ideapad2009/STM32-graphical-Equalizer/Images/STM32F413CG_WM8731.png

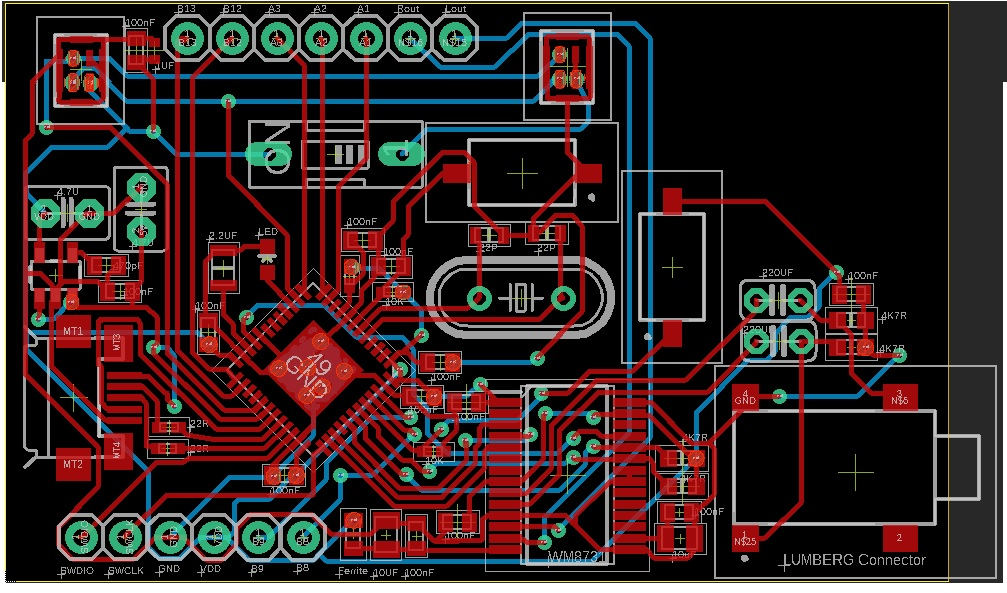
Images/STM32F413CG_WM8731.png
