ideapad2009/STM32-graphical-Equalizer/Images/Phase Response Matlab_2.png

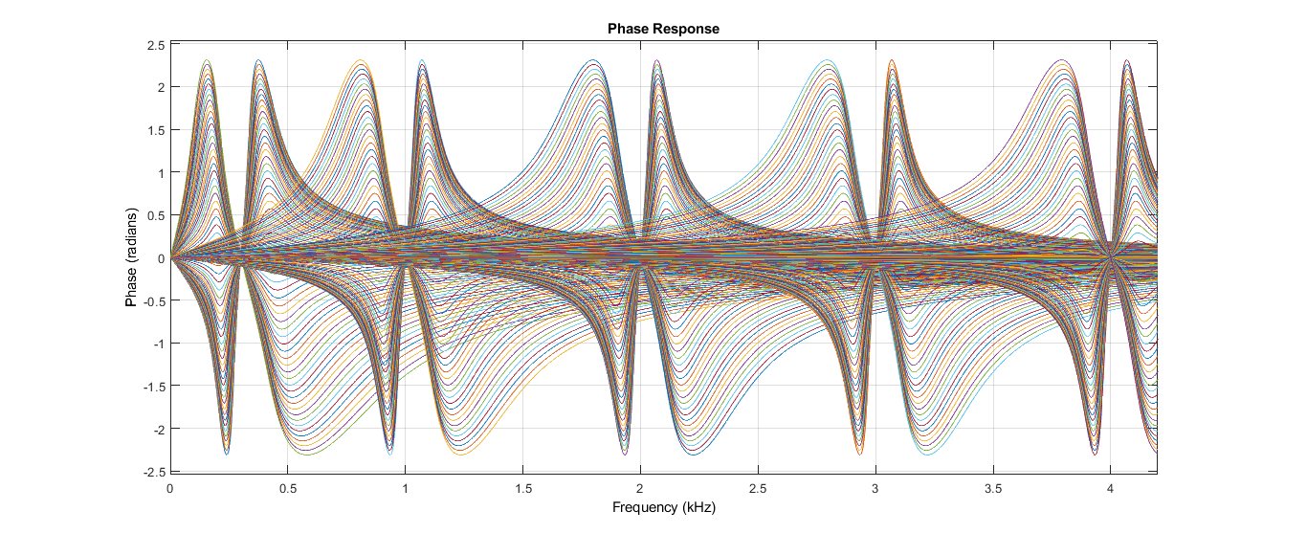
Images/Phase Response Matlab_2.png
