ideapad2009/STM32-graphical-Equalizer/README.md

# STM32-graphical-Equalizer
## STM32F413CG real-time graphical Equalizer using Mems Microphone & DFSDM for Audio Acquisition, I2S & WM8731 codec
