ideapad2009/STM32-graphical-Equalizer/Images/FFT Analyzer.PNG

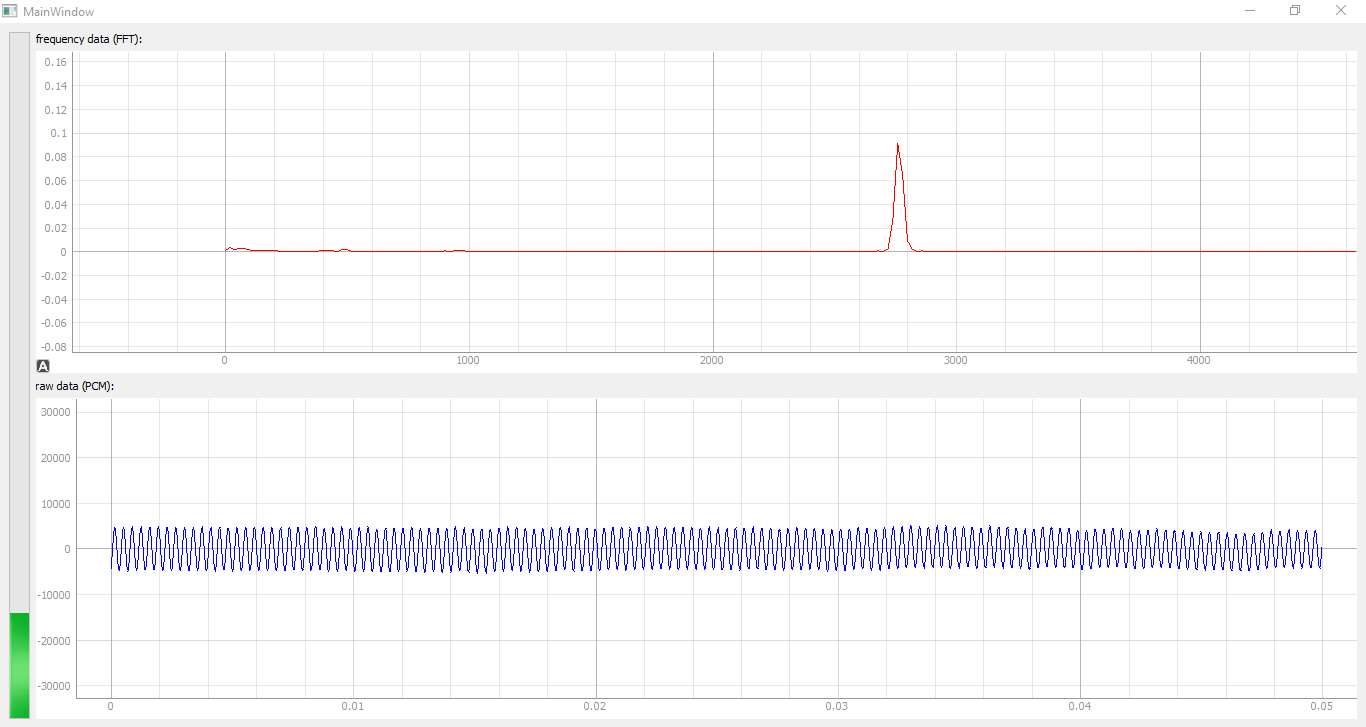
Images/FFT Analyzer.PNG
