ideapad2009/STM32-graphical-Equalizer/Images/Frequency Response Matlab.png

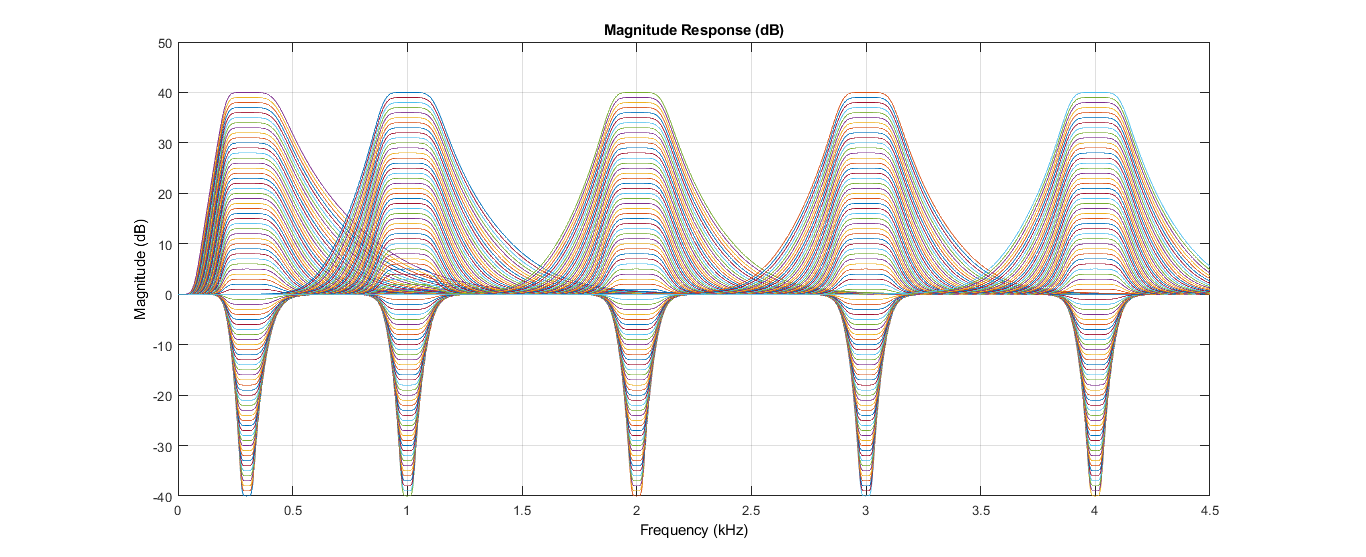
Images/Frequency Response Matlab.png
