ideapad2009/STM32-graphical-Equalizer/Images/Frequency Response Matlab_3.png

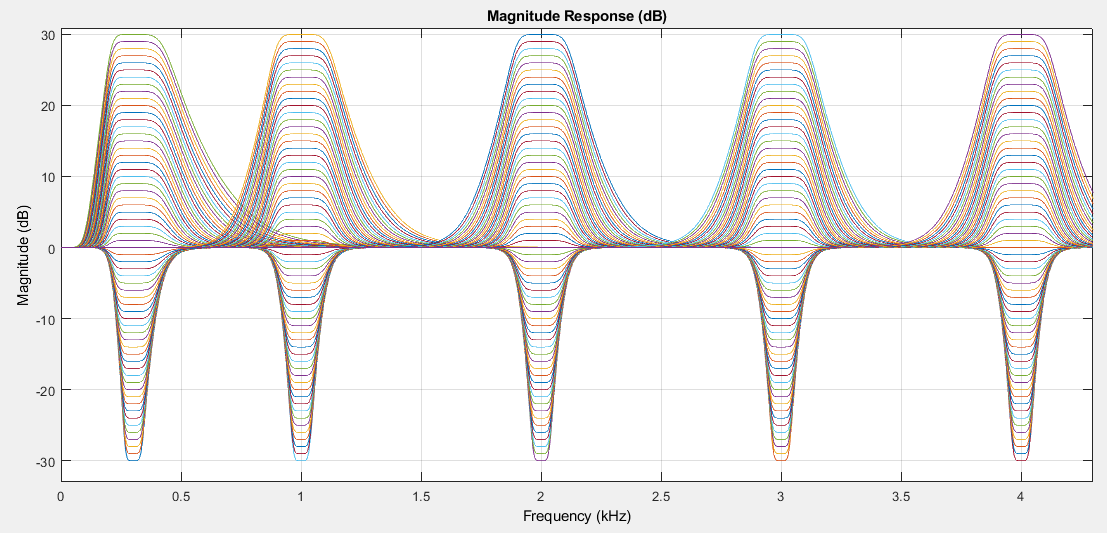
Images/Frequency Response Matlab_3.png
