ideapad2009/STM32-graphical-Equalizer/Images/HSI setting.PNG

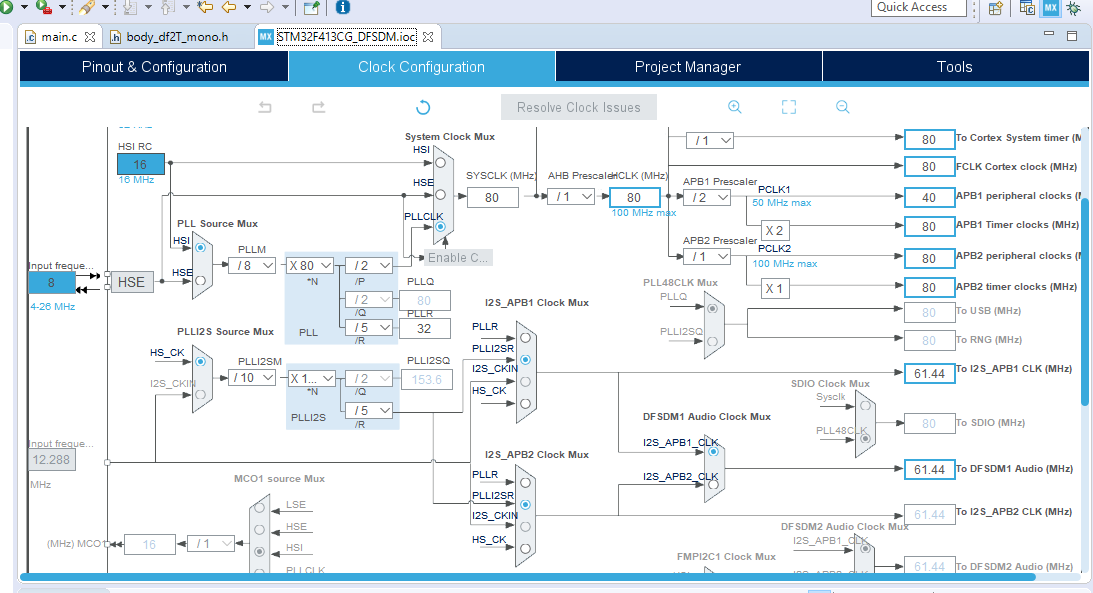
Images/HSI setting.PNG
