ideapad2009/STM32-graphical-Equalizer/Images/Mobile app.jpg

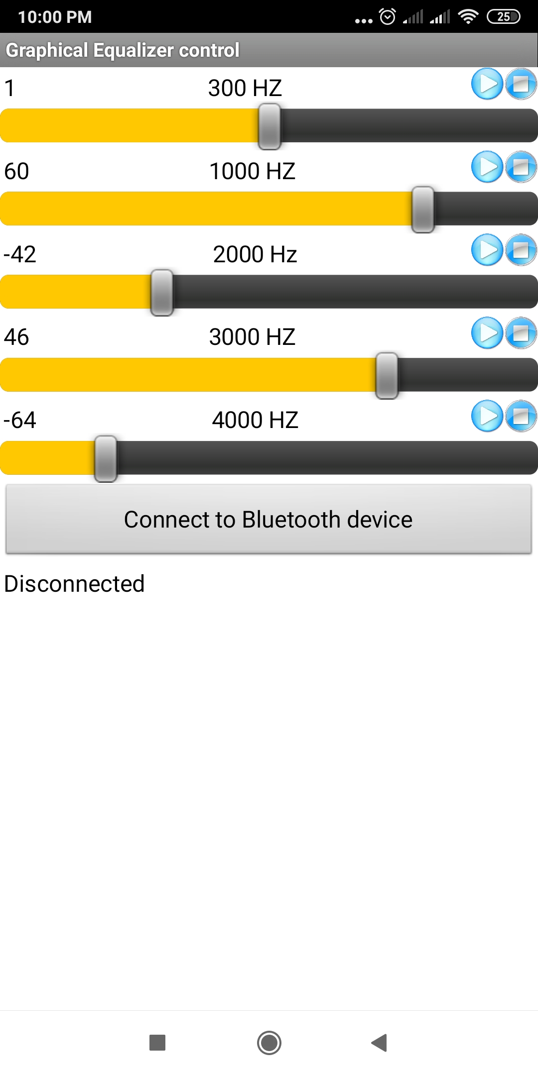
Images/Mobile app.jpg
