ideapad2009/STM32-graphical-Equalizer/Images/optimum CubeMX design printed PCB.PNG

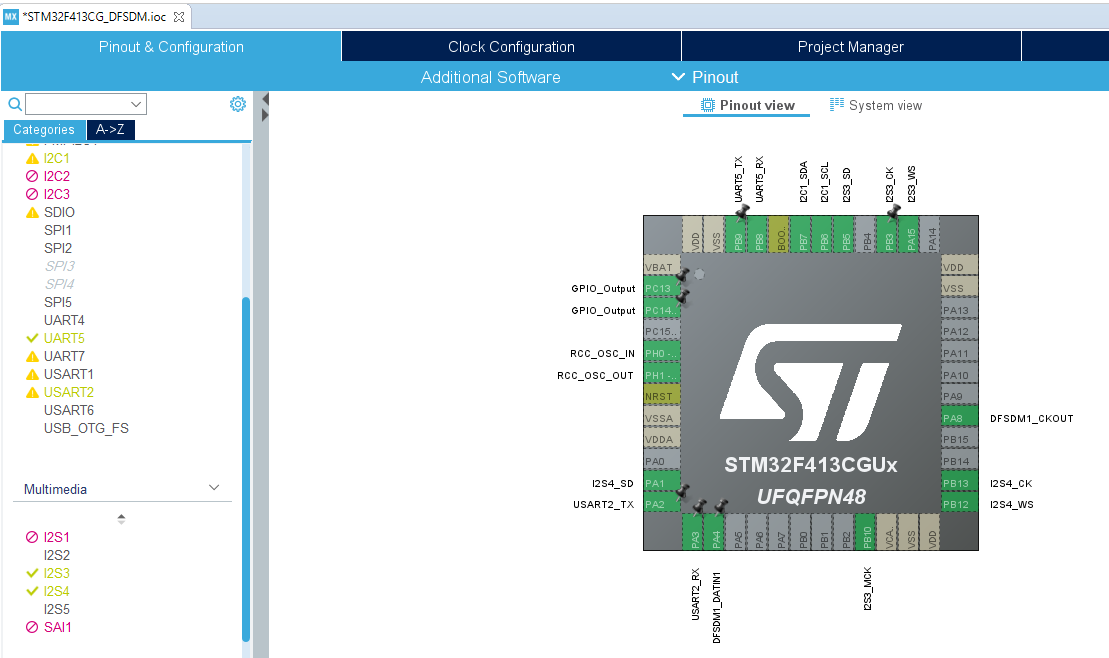
Images/optimum CubeMX design printed PCB.PNG
