ideapad2009/STM32-graphical-Equalizer/STM32F413CG_PCB/STM32F413CG_WM8731.brd

## EAGLE design STM32F413CG_PCB/STM32F413CG_WM8731.brd (2020-08-03)

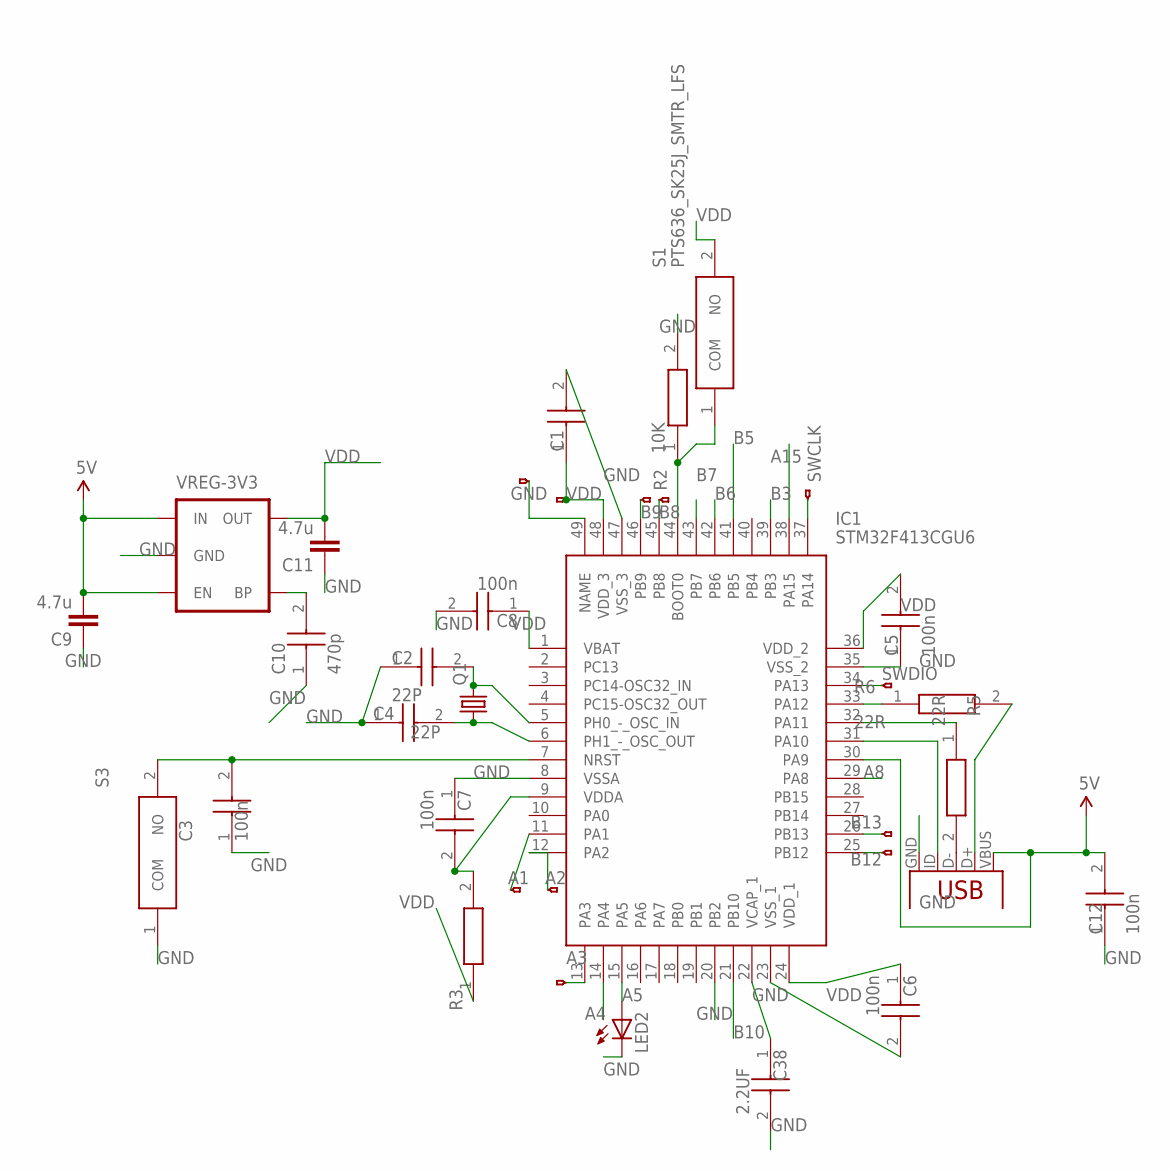
[picture p9: schematic STM32F413CG_WM8731.sch, sheet 1]

Parts:
C1: C0603C104M4RAC7411; CAPC1608X95N
C2, C4: 22P; CAPC1608X80N
C3, C5, C6, C7, C8, C12: 100n; CAPC1608X95N
C9, C11: 4.7u; C2.5-3
C10: 470p; CAPC1608X87N
C38: 2.2UF; CAPC2012X145N
IC1: STM32F413CGU6; QFN50P700X700X60-49N
JP1, JP2, JP3, JP4, JP5, JP6, JP7, JP8, JP9, JP10, JP11: HEADERHOLE-HEADERHOLE; 1X1-HEADER-HOLE
LED2: LED0603; LED-0603
Q1: CRYSTALHC49S; HC49/S
R2: 10K; RESC1005X40N
R3: CRCW040222R0FKED; RESC1005X40N
R5, R6: 22R; RESC1005X40N
S1, S3: PTS636_SK25J_SMTR_LFS; PTS636SK25JSMTRLFS
VREG-3V3: V_REG_LDOSMD; SOT23-5
X1: USB-MICROB-SMD

Connections:
5V: C9.2, C12.2, IC1.30 (PA9), VREG-3V3.1 (IN), VREG-3V3.3 (EN), X1.VBUS
A1: IC1.11 (PA1), JP8.1
A2: IC1.12 (PA2), JP9.1
A3: IC1.13 (PA3), JP10.1
A4: IC1.14 (PA4); also elsewhere on the board
A5: IC1.15 (PA5), LED2.A
A8: IC1.29 (PA8); also elsewhere on the board
A15: IC1.38 (PA15); also elsewhere on the board
B3: IC1.39 (PB3); also elsewhere on the board
B5: IC1.41 (PB5); also elsewhere on the board
B6: IC1.42 (PB6); also elsewhere on the board
B7: IC1.43 (PB7); also elsewhere on the board
B8: IC1.45 (PB8), JP5.1
B9: IC1.46 (PB9), JP11.1
B10: IC1.21 (PB10); also elsewhere on the board
B12: IC1.25 (PB12), JP7.1
B13: IC1.26 (PB13), JP6.1
GND: C1.2, C2.1, C3.1, C4.1, C5.1, C6.2, C7.1, C8.2, C9.1, C10.1, C11.1, C12.1, C38.2, IC1.8 (VSSA), IC1.20 (PB2), IC1.23 (VSS_1), IC1.35 (VSS_2), IC1.47 (VSS_3), IC1.49 (NAME), JP1.1, LED2.C, R2.2, S3.1 (COM), VREG-3V3.2 (GND), X1.GND; also elsewhere on the board
unnamed: C2.2, IC1.5 (PH0_-_OSC_IN), Q1.2
unnamed: C3.2, IC1.7 (NRST), S3.2 (NO)
unnamed: C10.2, VREG-3V3.4 (BP)
unnamed: C7.2, IC1.9 (VDDA), R3.2
unnamed: R5.2, X1.D-
unnamed: IC1.31 (PA10), X1.ID
unnamed: IC1.32 (PA11), R5.1
unnamed: R6.2, X1.D+
unnamed: IC1.33 (PA12), R6.1
unnamed: IC1.44 (BOOT0), R2.1, S1.1 (COM)
unnamed: C4.2, IC1.6 (PH1_-_OSC_OUT), Q1.1
unnamed: C38.1, IC1.22 (VCAP_1)
SWCLK: IC1.37 (PA14), JP2.1
SWDIO: IC1.34 (PA13), JP3.1
VDD: C1.1, C5.2, C6.1, C8.1, C11.2, IC1.1 (VBAT), IC1.24 (VDD_1), IC1.36 (VDD_2), IC1.48 (VDD_3), JP4.1, R3.1, S1.2 (NO), VREG-3V3.5 (OUT); also elsewhere on the board

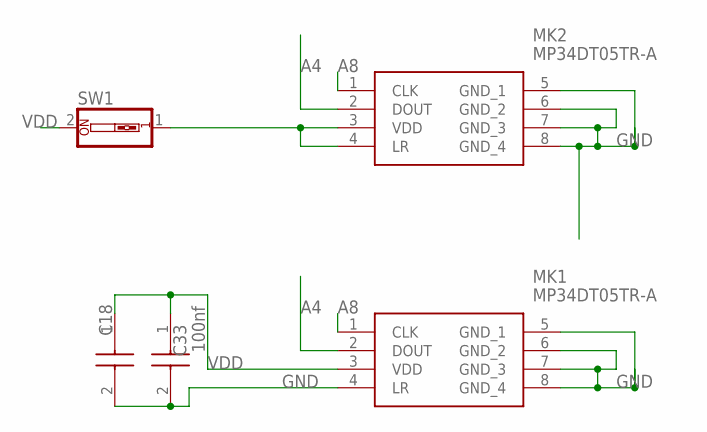
[picture p10: schematic STM32F413CG_WM8731.sch, sheet 2]

Parts:
C18: 1UF; CAPC1005X55N
C33: 100nf; CAPC1608X95N
MK1, MK2: MP34DT05TR-A; MP34DT05TRA
SW1: SW_DIP-1; EDG-01

Connections:
A4: MK1.2 (DOUT), MK2.2 (DOUT); also elsewhere on the board
A8: MK1.1 (CLK), MK2.1 (CLK); also elsewhere on the board
GND: C18.2 (C2), C33.2, MK1.4 (LR), MK1.5 (GND_1), MK1.6 (GND_2), MK1.7 (GND_3), MK1.8 (GND_4), MK2.5 (GND_1), MK2.6 (GND_2), MK2.7 (GND_3), MK2.8 (GND_4); also elsewhere on the board
unnamed: MK2.3 (VDD), MK2.4 (LR), SW1.1
VDD: C18.1 (C1), C33.1, MK1.3 (VDD), SW1.2; also elsewhere on the board

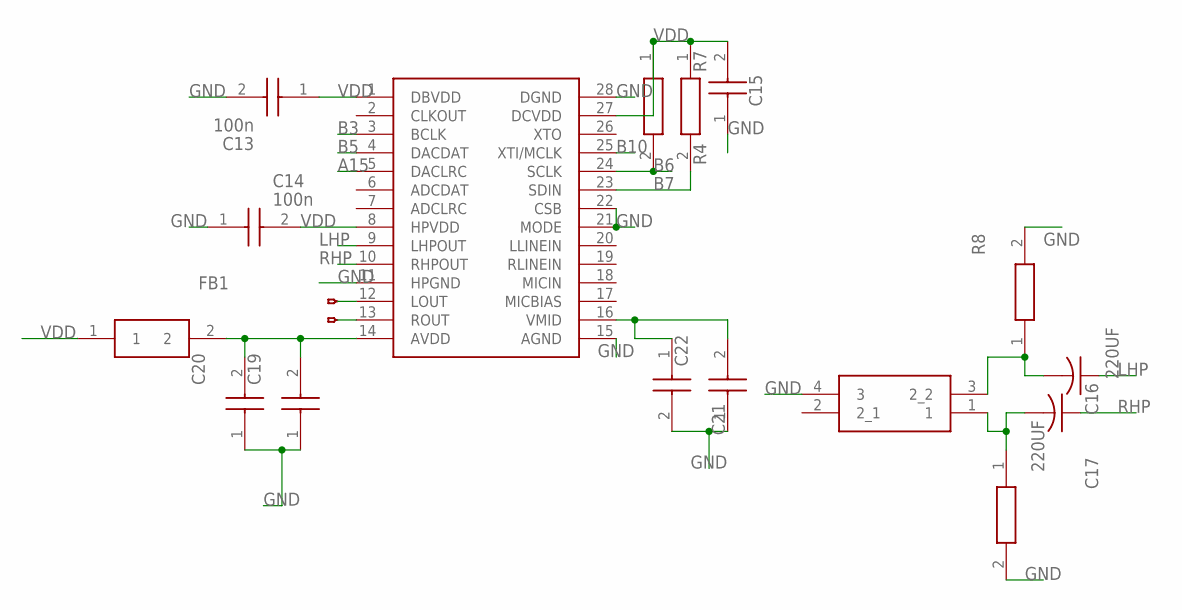
[picture p11: schematic STM32F413CG_WM8731.sch, sheet 3]

Parts:
C13, C14: 100n; CAPC1608X95N
C15, C19, C22: C0603C104M4RAC7411; CAPC1608X95N
C16, C17: 220UF; C025-024X044
C20: CL21A106KAYNNNE_10UF; CAPC2012X145N
C21: CL21A106KAYNNNE; CAPC2012X145N
FB1: BLM18BD252SN1D; BEADC1608X95N
IC2: WM8731SEDS_RV; SOP65P780X200-28N
J2: 1503_02; 150302
JP12, JP13: HEADERHOLE-HEADERHOLE; 1X1-HEADER-HOLE
R4, R7, R8, R9: CR0603-JW-472ELF; RESC1608X55N

Connections:
A15: IC2.5 (DACLRC); also elsewhere on the board
B3: IC2.3 (BCLK); also elsewhere on the board
B5: IC2.4 (DACDAT); also elsewhere on the board
B6: IC2.24 (SCLK), R4.2; also elsewhere on the board
B7: IC2.23 (SDIN), R7.2; also elsewhere on the board
B10: IC2.25 (XTI/MCLK); also elsewhere on the board
GND: C13.2, C14.1, C15.1, C19.1, C20.1, C21.2, C22.1, IC2.11 (HPGND), IC2.15 (AGND), IC2.21 (MODE), IC2.22 (CSB), IC2.28 (DGND), J2.4 (3), R8.2, R9.2; also elsewhere on the board
LHP: C16.1, IC2.9 (LHPOUT)
unnamed: C16.2, J2.3 (2_2), R8.1
unnamed: C19.2, C20.2, FB1.2, IC2.14 (AVDD)
unnamed: C21.1, C22.2, IC2.16 (VMID)
unnamed: IC2.12 (LOUT), JP13.1
unnamed: IC2.13 (ROUT), JP12.1
unnamed: C17.2, J2.1, R9.1
RHP: C17.1, IC2.10 (RHPOUT)
VDD: C13.1, C14.2, C15.2, FB1.1, IC2.1 (DBVDD), IC2.8 (HPVDD), IC2.27 (DCVDD), R4.1, R7.1; also elsewhere on the board

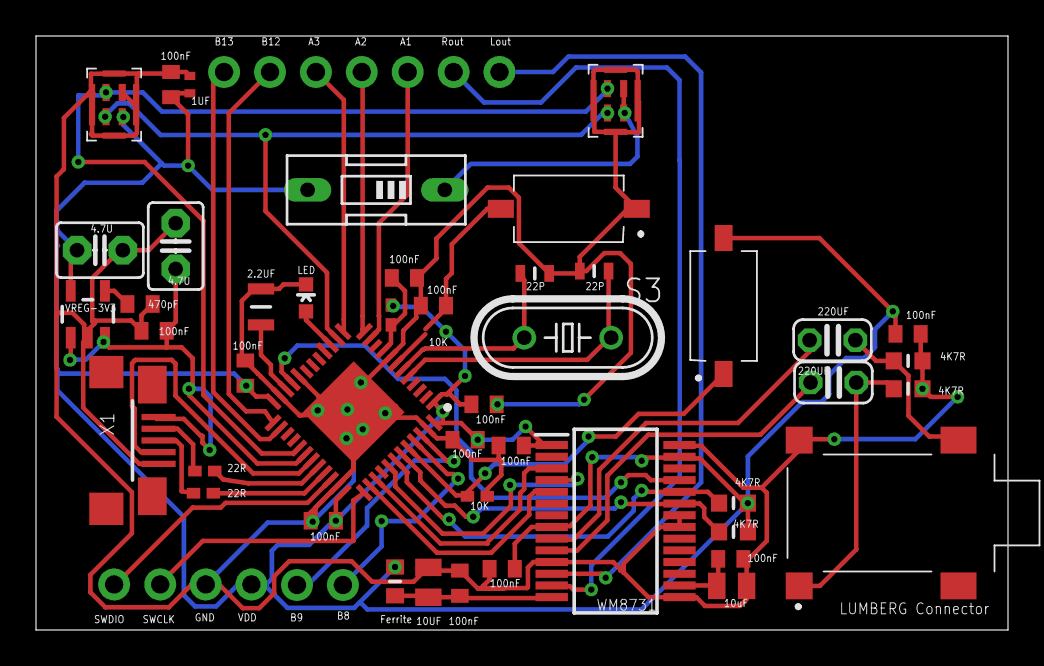
[picture p12: board STM32F413CG_WM8731.brd from above]

Board: 2 copper layers, 54.0 x 33.0 mm, 58 parts (0 on the bottom side), 42 nets.
