ideapad2009/STM32-graphical-Equalizer/STM32L451CE/STM32L451CE.ioc

Mcu.UserName=STM32L451CEUx
PA10.Signal=USART1_RX
PA4.Signal=COMP_DAC11_group
PA5.Signal=S_CKOUTDFSDM1
PA7.Signal=S_DATAIN0DFSDM1
PA8.Signal=GPIO_Output
PA9.Signal=USART1_TX
PB6.Signal=I2C1_SCL
PB7.Signal=I2C1_SDA
PB8.Signal=GPIO_Output
