ideapad2009/STM32-graphical-Equalizer/STM32L451CE/Core/Inc/biquad_band1.h

float band1_coeff[]={
1.000000000000000000f,-1.997781931884465179f,0.999323337720924743f,1.967549337575563495f,-0.969067417193793301f,
1.000000000000000000f,-1.998094240184478121f,0.999659087745291330f,1.976241389706033580f,-0.979288176314729863f,
1.000000000000000000f,-1.998145306585225267f,0.999664135552811417f,1.988802657704017207f,-0.989570745678425179f,
1.000000000000000000f,-1.997755489006195928f,0.999296874440425587f,1.967549337575563495f,-0.969067417193793301f,
1.000000000000000000f,-1.998079899219373345f,0.999645650273652486f,1.976241389706033580f,-0.979288176314729863f,
1.000000000000000000f,-1.998133168177066654f,0.999651100621309574f,1.988802657704017207f,-0.989570745678425179f,
1.000000000000000000f,-1.997728012363215067f,0.999269376597604286f,1.967549337575563495f,-0.969067417193793301f,
1.000000000000000000f,-1.998064988613399873f,0.999631679047974675f,1.976241389706033580f,-0.979288176314729863f,
1.000000000000000000f,-1.998120562734859940f,0.999637564154456260f,1.988802657704017207f,-0.989570745678425179f,
1.000000000000000000f,-1.997699461571394108f,0.999240803777174169f,1.967549337575563495f,-0.969067417193793301f,
1.000000000000000000f,-1.998049485393073255f,0.999617152587052638f,1.976241389706033580f,-0.979288176314729863f,
1.000000000000000000f,-1.998107472615963554f,0.999623507160251501f,1.988802657704017207f,-0.989570745678425179f,
1.000000000000000000f,-1.997669794671397048f,0.999211113987425237f,1.967549337575563495f,-0.969067417193793301f,
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
1.000000000000000000f,-1.997964600860201667f,0.999470082048267483f,1.988802657704017207f,-0.989570745678425179f,
1.000000000000000000f,-1.997344781636683164f,0.998885850186108315f,1.967549337575563495f,-0.969067417193793301f,
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
};
