ideapad2009/STM32-graphical-Equalizer/STM32L451CE/Core/Inc/biquad_band2.h

float band2_coeff[]={
1.000000000000000000f,-1.982218849408146299f,0.999323337720924743f,1.952221772475387196f,-0.969067417193793301f,
1.000000000000000000f,-1.982476809842899312f,0.999660858419490483f,1.961950954032809058f,-0.982825252057011434f,
1.000000000000000000f,-1.982631308281418425f,0.999662364872808573f,1.972204683312451579f,-0.986009393675632118f,
1.000000000000000000f,-1.982192612524680042f,0.999296874440425587f,1.952221772475387196f,-0.969067417193793301f,
1.000000000000000000f,-1.982460621285271785f,0.999647562124498568f,1.961950954032809058f,-0.982825252057011434f,
1.000000000000000000f,-1.982621223744882144f,0.999649188763692798f,1.972204683312451579f,-0.986009393675632118f,
1.000000000000000000f,-1.982165349929716047f,0.999269376597604286f,1.952221772475387196f,-0.969067417193793301f,
1.000000000000000000f,-1.982443796646624179f,0.999633743400717756f,1.961950954032809058f,-0.982825252057011434f,
1.000000000000000000f,-1.982610746690344428f,0.999635499793817606f,1.972204683312451579f,-0.986009393675632118f,
1.000000000000000000f,-1.982137021553725731f,0.999240803777174169f,1.952221772475387196f,-0.969067417193793301f,
1.000000000000000000f,-1.982426310811993275f,0.999619381629718196f,1.961950954032809058f,-0.982825252057011434f,
1.000000000000000000f,-1.982599861933033836f,0.999621278108382194f,1.972204683312451579f,-0.986009393675632118f,
1.000000000000000000f,-1.982107585764243840f,0.999211113987425237f,1.952221772475387196f,-0.969067417193793301f,
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
1.000000000000000000f,-1.982480738816681853f,0.999465635411969755f,1.972204683312451579f,-0.986009393675632118f,
1.000000000000000000f,-1.981785104639837369f,0.998885850186108315f,1.952221772475387196f,-0.969067417193793301f,
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
};
