ideapad2009/STM32-graphical-Equalizer/STM32L451CE/Core/Inc/biquad_band3.h

float band3_coeff[]={
1.000000000000000000f,-1.931198047007102181f,0.999323337720924743f,1.901973071971796214f,-0.969067417193793301f,
1.000000000000000000f,-1.931372575661876478f,0.999661241555557689f,1.908690275083634980f,-0.983631990003573931f,
1.000000000000000000f,-1.931676681578337718f,0.999661981736307159f,1.924203194641800563f,-0.985200705872032456f,
1.000000000000000000f,-1.931172485441019493f,0.999296874440425587f,1.901973071971796214f,-0.969067417193793301f,
1.000000000000000000f,-1.931353815083105108f,0.999647975826320812f,1.908690275083634980f,-0.983631990003573931f,
1.000000000000000000f,-1.931669845312370848f,0.999648775061373063f,1.924203194641800563f,-0.985200705872032456f,
1.000000000000000000f,-1.931145924564471317f,0.999269376597604286f,1.901973071971796214f,-0.969067417193793301f,
1.000000000000000000f,-1.931334319112118392f,0.999634190113312671f,1.908690275083634980f,-0.983631990003573931f,
1.000000000000000000f,-1.931662742314942616f,0.999635053080640268f,1.924203194641800563f,-0.985200705872032456f,
1.000000000000000000f,-1.931118325339287844f,0.999240803777174169f,1.901973071971796214f,-0.969067417193793301f,
1.000000000000000000f,-1.931314058862607874f,0.999619863967125877f,1.908690275083634980f,-0.983631990003573931f,
1.000000000000000000f,-1.931655362209912408f,0.999620795770289172f,1.924203194641800563f,-0.985200705872032456f,
1.000000000000000000f,-1.931089647204592419f,0.999211113987425237f,1.901973071971796214f,-0.969067417193793301f,
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
1.000000000000000000f,-1.931574547542096898f,0.999464673178202645f,1.924203194641800563f,-0.985200705872032456f,
1.000000000000000000f,-1.930775466498543480f,0.998885850186108315f,1.901973071971796214f,-0.969067417193793301f,
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
};
