ideapad2009/STM32-graphical-Equalizer/STM32L451CE/Core/Inc/biquad_band4.h

float band4_coeff[]={
1.000000000000000000f,-1.847133910592513306f,0.999323337720924743f,1.819181084880208354f,-0.969067417193793301f,
1.000000000000000000f,-1.847221762004602308f,0.999661372240002066f,1.822217622647379187f,-0.983908521949802384f,
1.000000000000000000f,-1.847670790520528517f,0.999661851051785177f,1.843831809512394670f,-0.984923810751662465f,
1.000000000000000000f,-1.847109461709296907f,0.999296874440425587f,1.819181084880208354f,-0.969067417193793301f,
1.000000000000000000f,-1.847200729725531954f,0.999648116943525289f,1.822217622647379187f,-0.983908521949802384f,
1.000000000000000000f,-1.847667340173384964f,0.999648633944072884f,1.843831809512394670f,-0.984923810751662465f,
1.000000000000000000f,-1.847084057015126124f,0.999269376597604286f,1.819181084880208354f,-0.969067417193793301f,
1.000000000000000000f,-1.847178873679625966f,0.999634342475216098f,1.822217622647379187f,-0.983908521949802384f,
1.000000000000000000f,-1.847663755091376814f,0.999634900718624042f,1.843831809512394670f,-0.984923810751662465f,
1.000000000000000000f,-1.847057659171144728f,0.999240803777174169f,1.819181084880208354f,-0.969067417193793301f,
1.000000000000000000f,-1.847156161556028131f,0.999620028484866308f,1.822217622647379187f,-0.983908521949802384f,
1.000000000000000000f,-1.847660030031984313f,0.999620631252425618f,1.843831809512394670f,-0.984923810751662465f,
1.000000000000000000f,-1.847030229382071065f,0.999211113987425237f,1.819181084880208354f,-0.969067417193793301f,
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
1.000000000000000000f,-1.847619231353760494f,0.999464344982851194f,1.843831809512394670f,-0.984923810751662465f,
1.000000000000000000f,-1.846729724813367612f,0.998885850186108315f,1.819181084880208354f,-0.969067417193793301f,
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
};
