ideapad2009/STM32-graphical-Equalizer/STM32L451CE/Core/Inc/biquad_band5.h

float band5_coeff[]={
1.000000000000000000f,-1.731464800845415652f,0.999323337720924743f,1.705262405054036590f,-0.969067417193793301f,
1.000000000000000000f,-1.731464404183024275f,0.999661439886804004f,1.704420959392325408f,-0.984051835416423382f,
1.000000000000000000f,-1.732050807635567846f,0.999661783404954374f,1.732057312996608811f,-0.984780370293960150f,
1.000000000000000000f,-1.731441882972235780f,0.999296874440425587f,1.705262405054036590f,-0.969067417193793301f,
1.000000000000000000f,-1.731441454670316737f,0.999648189985098079f,1.704420959392325408f,-0.984051835416423382f,
1.000000000000000000f,-1.732050807645114876f,0.999648560902466232f,1.732057312996608811f,-0.984780370293960150f,
1.000000000000000000f,-1.731418069141803295f,0.999269376597604286f,1.705262405054036590f,-0.969067417193793301f,
1.000000000000000000f,-1.731417606679332755f,0.999634421345324098f,1.704420959392325408f,-0.984051835416423382f,
1.000000000000000000f,-1.732050807653427782f,0.999634821848477406f,1.732057312996608811f,-0.984780370293960150f,
1.000000000000000000f,-1.731393324353453167f,0.999240803777174169f,1.705262405054036590f,-0.969067417193793301f,
1.000000000000000000f,-1.731392825004421931f,0.999620113644775321f,1.704420959392325408f,-0.984051835416423382f,
1.000000000000000000f,-1.732050807664428982f,0.999620546092472861f,1.732057312996608811f,-0.984780370293960150f,
1.000000000000000000f,-1.731367612241297538f,0.999211113987425237f,1.705262405054036590f,-0.969067417193793301f,
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
1.000000000000000000f,-1.732050807837191675f,0.999464175096755558f,1.732057312996608811f,-0.984780370293960150f,
1.000000000000000000f,-1.731085925526425706f,0.998885850186108315f,1.705262405054036590f,-0.969067417193793301f,
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
};
