ideapad2009/STM32-graphical-Equalizer/STM32F413CG_DFSDM/Core/Inc/codec_WM8731.h

/*
 * codec_WM8731.h
 *
 *  Created on: Feb 19, 2020
 *      Author: Hanna Nabil
 */

#ifndef INC_CODEC_WM8731_H_
#define INC_CODEC_WM8731_H_

#include "stm32f4xx.h"





/*----------------------------------------------------------------------------*/

/* High Layer codec functions */
uint32_t Codec_Init(uint32_t AudioFreq);

void     Codec_Reset(I2C_HandleTypeDef *i2c_handle);
uint32_t Codec_WriteRegister(uint8_t RegisterAddr, uint16_t RegisterValue);


#endif /* INC_CODEC_WM8731_H_ */
