ideapad2009/STM32-graphical-Equalizer/(commit log)

2020-04-24 STM32F413CG project
2020-07-18 Successfully test DAC with Timer6
2020-07-25 Revert "Successfully test DAC with Timer6"
    This reverts commit ac6be118d610ab295486c276112780f5274638ee.
    [STM32F413CG_DFSDM.ioc, body_DAC_DFSDM.h]
2020-08-03 added PCB files
    [STM32F413CG_WM8731.brd, STM32F413CG_WM8731.sch]
2020-08-15 finally STM32CubeMx version 6.0.1 changes update
2020-08-24 added STM32L451CE files
2020-08-25 changed Sinc order in STM32L451CE
